CircuitCo/BeagleBone-LCD3/(list of files, drawings)

Other design files:
BeagleBone-LCD3-RevA-schematic.dsn
